Cahudisa/Proyecto-Medidor-de-Corriente-para-Microcontroladores/PCB/modulo_bateria/How-to-order-PCB.txt

How to Order PCB

Please refer to:
https://docs.easyeda.com/en/PCB/Order-PCB
