Cahudisa/Proyecto-Medidor-de-Corriente-para-Microcontroladores/costos.pdf

Manufacturer Part | Precio unidad USD | Precio al por mayor USD | Total unidad 25 | Total al por mayor 25
AD8628ARTZ-REEL7 | 4.69 | 2.6124 | 117.25 | 65.31
CC0603JRX7R9BB473 | 0.1 | 0.056 | 2.5 | 1.4
CC0402JRX7R7BB104 | 0.08 | 0.01 | 2 | 0.25
C0805C106J8RACAUTO | 0.88 | 0.556 | 22 | 13.9
LMV761MFX | 2.13 | 1.4348 | 53.25 | 35.87
PESDNC5D5VB | 0.03689 | 0.03689 | 0.92225 | 0.92225
ASMD1206-035 | 0.0691 | 0.0691 | 1.7275 | 1.7275
PTC120612V200 | 0.5 | 0.5 | 12.5 | 12.5
RT0805BRD074R7L | 0.18 | 0.131 | 4.5 | 3.275
RC0805JR-0710KL | 0.1 | 0.012 | 2.5 | 0.3
INA228AQDGSRQ1 | 4.22 | 2.942 | 105.5 | 73.55
TC1262-3.3VDBTR | 0.69 | 0.58 | 17.25 | 14.5
LTST-C170GKT | 0.16 | 0.11 | 4 | 2.75
74LVC1G02GW | 0.1 | 0.0532 | 2.5 | 1.33
WJ301V-5.0-3P | 16.6 | 16.6 | 415 | 415
IRF7410TRPBF | 1.3 | 0.873 | 32.5 | 21.825
Y14870R01000B9R | 12.8 | 7.8692 | 320 | 196.73
CPF0402B10RE1 | 0.25 | 0.211 | 6.25 | 5.275
RN73H1JTTD1002B25 | 0.1 | 0.082 | 2.5 | 2.05
RN73H1JTTD3602B25 | 0.1 | 0.082 | 2.5 | 2.05
RG1608P-471-B-T5 | 0.1 | 0.076 | 2.5 | 1.9
RT0603BRD07120RL | 0.14 | 0.108 | 3.5 | 2.7
RT0603BRD0739K2L | 0.14 | 0.104 | 3.5 | 2.6
D55342E07B500BRWS | 9.7504 | 9.7504 | 243.76 | 243.76
EG1218 | 0.84 | 0.664 | 21 | 16.6
74LVC1G32GW/C4125 | 0.1 | 0.05 | 2.5 | 1.25
ESP32-S2-SOLO-2-N4R2 | 4.51 | 3.6904 | 112.75 | 92.26
BD4928G-TR | 0.54 | 0.3388 | 13.5 | 8.47
FS312F-G | 0.0694 | 0.279 | 1.735 | 6.975
Green LED | 0.005 | 0.005 | 0.125 | 0.125
Red LED | 0.006 | 0.006 | 0.15 | 0.15
100R | 0.0011 | 0.0011 | 0.0275 | 0.0275
2R2 | 0.16 | 0.16 | 4 | 4
91K | 0.005 | 0.005 | 0.125 | 0.125
120K | 0.0236 | 0.0236 | 0.59 | 0.59
1K | 0.0011 | 0.0011 | 0.0275 | 0.0275
270K | 0.007 | 0.007 | 0.175 | 0.175
910K | 0.008 | 0.008 | 0.2 | 0.2
51K | 0.006 | 0.006 | 0.15 | 0.15
47K | 0.006 | 0.006 | 0.15 | 0.15
FS8205 | 0.37 | 0.37 | 9.25 | 9.25
MCW-0630-1R5-S1 | 0.1 | 0.1 | 2.5 | 2.5
10uF / 16V | 0.1 | 0.1 | 2.5 | 2.5
22uF / 10V | 0.1 | 0.1 | 2.5 | 2.5
100nF / 50V | 0.1 | 0.1 | 2.5 | 2.5
IP2312U | 0.25 | 0.25 | 6.25 | 6.25
U254-051N-4BH806 | 0.5 | 0.5 | 12.5 | 12.5
Costo de fabricación | 28.82 | 28.82 | 720.5 | 720.5
Suma total | 91.84459 | 80.44999 | 2296.11475 | 2011.24975
