Cahudisa/Proyecto-Medidor-de-Corriente-para-Microcontroladores/PCB/modulo_bateria/Diagrama Esquematico Tema Oscuro.pdf

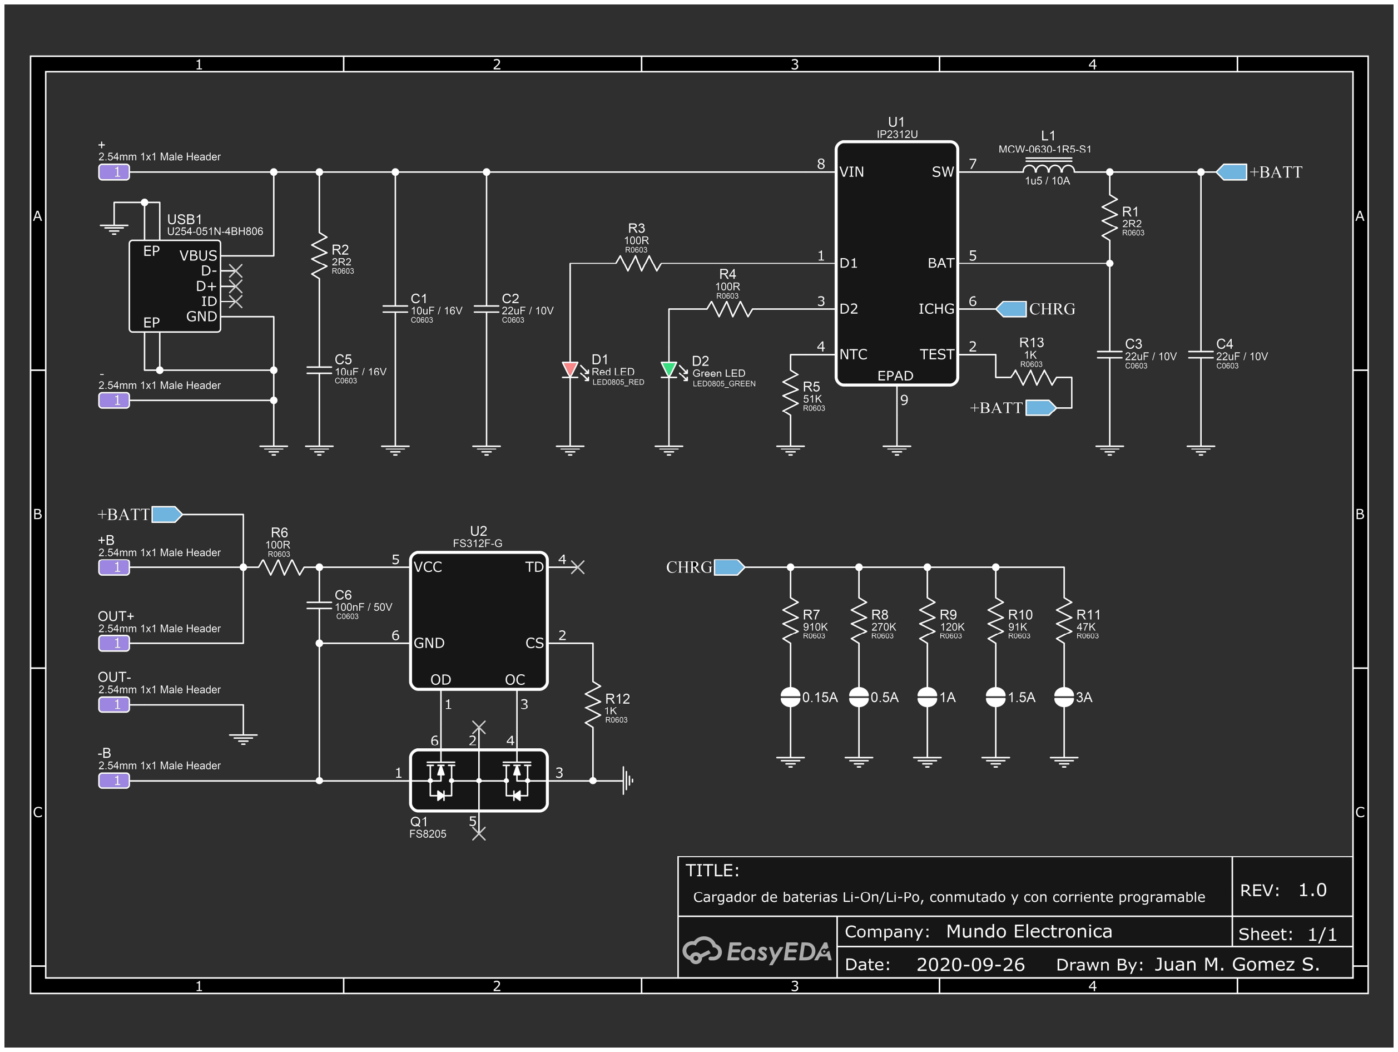
[picture p23: page 1]
