Cahudisa/Proyecto-Medidor-de-Corriente-para-Microcontroladores/PCB/modulo_bateria/BOM_modulo_bateria.pdf

ID | Name | Designator | Footprint | Quantity
1 | FS312F-G | U2 | SOT-23-6 | 1
2 | Green LED | D2 | 0805 | 1
3 | Red LED | D1 | 0805 | 1
4 | 100R | R3,R6,R4 | 0603 | 3
5 | 2R2 | R1,R2 | 0603 | 2
6 | 91K | R10 | 0603 | 1
7 | 120K | R9 | 0603 | 1
8 | 1K | R12,R13 | 0603 | 2
9 | 270K | R8 | 0603 | 1
10 | 910K | R7 | 0603 | 1
11 | 51K | R5 | 0603 | 1
12 | 47K | R11 | 0603 | 1
13 | FS8205 | Q1 | SOT-23-6 | 1
14 | MCW-0630-1R5-S1 | L1 | N/A | 1
15 | 10uF / 16V | C5,C1 | 0603 | 2
16 | 22uF / 10V | C3,C4,C2 | 0603 | 3
17 | 100nF / 50V | C6 | 0603 | 1
18 | IP2312U | U1 | N/A | 1
19 | U254-051N-4BH806 | USB1 | N/A | 1
