Cahudisa/Proyecto-Medidor-de-Corriente-para-Microcontroladores/PCB/BOM_Proyecto_final_DSE_2025-05-28.csv

ID | Name | Designator | Footprint | Quantity | Manufacturer Part | Manufacturer | Supplier | Supplier Part | Price
1 | AD8628ARTZ-REEL7 | AD8628 | SOT-23-5_L3.0-W1.7-P0.95-LS2.8-BR | 1 | AD8628ARTZ-REEL7 | ADI(亚德诺) | LCSC | C29309 | 1.895
2 | HDR-M-2.54_1x1 | BOOT,RX,TX,VBAT+,VBAT- | HDR-M-2.54_1X1 | 5 |  |  | LCSC | C81276 | 0.007
3 | 47nF | C1,C2 | C0603 | 2 | CC0603JRX7R9BB473 | YAGEO | LCSC | C519554 | 0.004
4 | 100nF | C3,C6 | C0402 | 2 | CC0402JRX7R7BB104 | YAGEO(国巨) | LCSC | C541464 | 0.002
5 | 10uF | C4,C5,C7,C8 | C0805 | 4 | C0805C106J8RACAUTO | KEMET | LCSC | C599861 | 0.664
6 | LMV761MFX | COMP1,COMP2 | SOT-23-6_L2.9-W1.6-P0.95-LS2.8-BR | 2 | LMV761MFX | TI(德州仪器) | LCSC | C2861042
7 | PESDNC5D5VB | D1 | SOD-523_L1.2-W0.8-LS1.6-BI | 1 | PESDNC5D5VB | Prisemi(芯导) | LCSC | C110698 | 0.02
8 | ASMD1206-035 | F1 | F1206 | 1 | ASMD1206-035 | JDTfuse(集电通) | LCSC | C135337 | 0.052
9 | PTC120612V200 | F2 | F1206 | 1 | PTC120612V200 | null | LCSC | C9900019163
10 | 4.7Ω | F3 | R0805 | 1 | RT0805BRD074R7L | YAGEO(国巨) | LCSC | C784587 | 0.046
11 | 10kΩ | R6,R7,R8,R9 | R0805 | 4 | RC0805JR-0710KL | YAGEO(国巨) | LCSC | C100047 | 0.002
12 | INA228AQDGSRQ1 | INA228 | VSSOP-10_L3.0-W3.0-P0.50-LS4.9-BL | 1 | INA228AQDGSRQ1 | TI(德州仪器) | LCSC | C5214669 | 4.007
13 | TC1262-3.3VDBTR | LDO | SOT-223_L6.5-W3.5-P2.30-LS7.0-BR | 1 | TC1262-3.3VDBTR | MICROCHIP(美国微芯) | LCSC | C52507 | 1.393
14 | LTST-C170GKT | LED1 | LED0805-RD_GREEN | 1 | LTST-C170GKT | LITEON(光宝) | LCSC | C125090 | 0.026
15 | 74LVC1G02GW | NOR1,NOR2 | SOT-353_L2.1-W1.3-P0.65-LS2.3-BL | 2 | 74LVC1G02GW | TECH PUBLIC(台舟) | LCSC | C41407550 | 0.037
16 | WJ301V-5.0-3P | P1 | CONN-TH_2P-P5.00_WJ301V-5.00-3P | 1 | WJ301V-5.0-3P | KANGNEX(康奈克斯电气) | LCSC | C8483 | 0.122
17 | ISCH42N04LM7ATMA1 | Q1_NMOS,Q2_NMOS,Q3_NMOS | IAUC120N06S5N011ATMA1 | 3
18 | IRF7410TRPBF_C5370971 | Q2_PMOS | SOP-8_L5.1-W3.9-P1.27-LS6.0-BL | 1 | IRF7410TRPBF | TECH PUBLIC(台舟) | LCSC | C5370971 | 0.232
19 | 10mΩ | R1 | RES-SMD_4P-L6.4-W3.2-A | 1 | Y14870R01000B9R | VISHAY(威世) | LCSC | C4147986 | 3.892
20 | 10Ω | R2 | R0402 | 1 | CPF0402B10RE1 | TE Connectivity(泰科电子) | LCSC | C2073458 | 0.133
21 | 10kΩ | R3,R4 | R0603 | 2 | RN73H1JTTD1002B25 | KOA | LCSC | C186210 | 0.226
22 | 36kΩ | R5,R10 | R0603 | 2 | RN73H1JTTD3602B25 | KOA | LCSC | C186223 | 0.096
23 | 470Ω | R11 | R0603 | 1 | RG1608P-471-B-T5 | SUSUMU | LCSC | C328637 | 0.149
24 | 120Ω | R12 | R0603 | 1 | RT0603BRD07120RL | YAGEO(国巨) | LCSC | C861094 | 0.024
25 | 39.2kΩ | R13 | R0603 | 1 | RT0603BRD0739K2L | YAGEO(国巨) | LCSC | C861369 | 0.024
26 | 500kΩ | R14 | R1206 | 1 | D55342E07B500BRWS | VISHAY(威世) | LCSC | C4018189 | 12.621
27 | EG1218 | SW2 | SW-TH_EG1218 | 1 | EG1218 | E-Switch | LCSC | C273394 | 0.744
28 | 74LVC1G32GW/C4125 | U1,U2 | TSSOP-5_L2.0-W1.3-P0.65-LS2.1-BR | 2 | 74LVC1G32GW/C4125 | NXP(恩智浦) | LCSC | C4470879 | 0.033
29 | ESP32-S2-SOLO-2-N4R2 | U4 | WIRELM-SMD_ESP32-S3-WROOM-1 | 1 | ESP32-S2-SOLO-2-N4R2 | ESPRESSIF(乐鑫) | LCSC | C7188709 | 3.789
30 | BD4928G-TR | U6 | SSOP-5_L2.9-W1.6-P0.95-LS2.8-TL | 1 | BD4928G-TR | ROHM(罗姆) | LCSC | C2066490 | 0.239
