Cahudisa/Proyecto-Medidor-de-Corriente-para-Microcontroladores/PCB/modulo_bateria/Diagrama Esquematico Tema Blanco.pdf

U1

R2

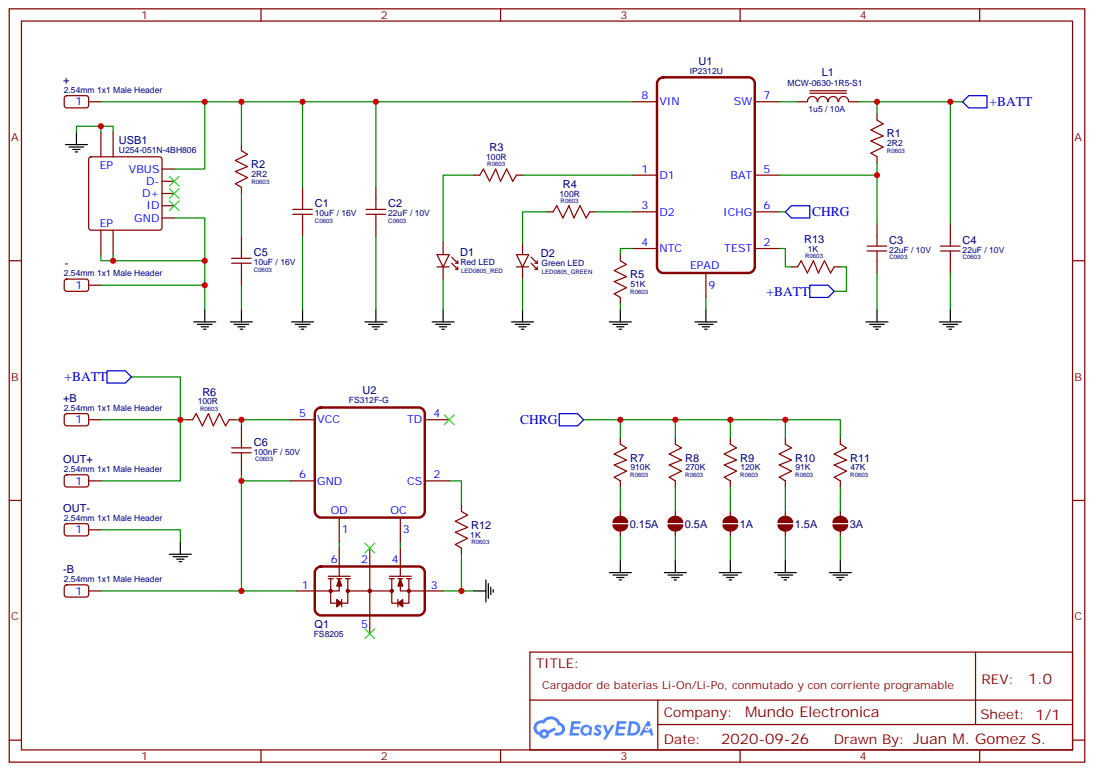
[picture p24: page 1]

Drawn By: Juan M. Gomez S.
