Cahudisa/Proyecto-Medidor-de-Corriente-para-Microcontroladores/Simulacion/AD8628_char.asc

R1: res; 1k
U1: AD8628
U2: AD8628
V1: voltage; 0.5
V2: voltage; 0
Vdd1: voltage; 3.3
Named nets: vdd3, 0, vout, v+, v-, vout_noise
.op
.dc V1 0.3 1.2 0.0001
.meas DC min MIN v(vout) FROM 0.99 TO 1.01
.meas DC max MAX v(vout) FROM 0.99 TO 1.02
.meas DC vtrig TRIG v(vout)=min CROSS=last TARG v(vout)=max
.meas DC offset FIND v(vout) WHEN v(vout)=3.3/2-0.001
.noise v(vout_noise) V2 dec 100 1 10g
