Cahudisa/Proyecto-Medidor-de-Corriente-para-Microcontroladores/Simulacion/Control digital.asc

C1: cap; 1µ
C2: cap; 1µ
R1: res; 40.3k
R2: res; 470
R3: res; 32.9k
R4: res; 100
U1: TLV3501
U2: TLV3501
U3: LT1017
U4: LT1017
Vdd1: voltage; 3.3
Vdd2: voltage; PULSE(1m 50m 1u 1000m 1000m)
Named nets: 0, vdd1, vmax, vmin, vout, vmaxc, vminc, vmaxc2, vminc2
.include LMV761.lib
.dc Vdd2 8m 40m
.tran 1
.include TLV3501.lib
