Cahudisa/Proyecto-Medidor-de-Corriente-para-Microcontroladores/Simulacion/preamp_auto_tran.asc

A1: srflop
C1: cap; {C}
C2: cap; {C}
C3: cap; 1µ
C4: cap; 1µ
E1: e; 3.3
E2: e; 3.3
I1: current; PULSE(1u 1.5m 10u 5 5)
M1: nmos; ISCH42N04LM7_L0
M2: nmos; ISCH42N04LM7_L0
M3: nmos; ISCH42N04LM7_L0
R1: res; {Rin}
R2: res; {Rin}
R3: res; {Rf}
R4: res; {Rf}
R5: res; {Rshunt}
R6: res; {Rshunt2}
R9: res; 39.3k
R10: res; 470
R11: res; 500k
R12: res; 5
U1: AD8628
U2: LT1017; LMV761
U3: LT1017; LMV761
Vdd1: voltage; 3.3
Named nets: vdd, 0, vout, vmos, vmosn, vmax, vmin, vmaxc, vminc, vshunt
.dc I1 1u 1
.tran 10
Low side
.include OptiMOS7_40V_LTSpice.lib
.param C = 47n
.param Iload = 1
.param scale = 10
.param Rin = 1k*scale
.param Rf 3.6k*scale
.param tol = 0.001
.param tolcap = 0.05
.param Rshunt = 10m
.param Rshunt2 = 10
.include LMV761.lib
