Cahudisa/Proyecto-Medidor-de-Corriente-para-Microcontroladores/Simulacion/Preamp_mA_noise.asc

C1: cap; {C}
C2: cap; {C}
I1: current; {Iload}
M1: nmos; ISCH42N04LM7_L0
M2: nmos; ISCH42N04LM7_L0
M3: nmos; ISCH42N04LM7_L0
R1: res; {Rin}
R2: res; {Rin}
R3: res; {Rf}
R4: res; {Rf}
R5: res; {Rshunt}
R6: res; {Rshunt2}
R7: res; 100 noiseless
R8: res; 100 noiseless
U1: AD8628
V1: voltage; 3.3
V2: voltage; 0
Vdd1: voltage; 3.3
Named nets: vdd3, 0, vout, vmos, vmosn, vshunt+, vshunt-, v+, v-
.op
Low side
.include OptiMOS7_40V_LTSpice.lib
.noise v(vout) I1 dec 100 1 20meg
.param C = 47n
.param Iload = 1
.param scale = 10
.param Rin = 1k*scale
.param Rf 3.6k*scale
.param tol = 0.001
.param tolcap = 0.05
.param Rshunt = 10m
.param Rshunt2 = 10
