Cahudisa/Proyecto-Medidor-de-Corriente-para-Microcontroladores/Simulacion/Preamp_mc.asc

C1: cap; {mc(C,tolcap)}
C2: cap; {mc(C,tolcap)}
C3: cap; {mc(C,tolcap)}
C4: cap; {mc(C,tolcap)}
I1: current; {Iload1}
I2: current; {Iload2}
M1: nmos; ISCH42N04LM7_L0
M2: nmos; ISCH42N04LM7_L0
M3: nmos; ISCH42N04LM7_L0
R1: res; 1k
R2: res; {mc(Rin,tol)}
R3: res; {mc(Rin,tol)}
R4: res; {mc(Rf,tol)}
R5: res; {mc(Rf,tol)}
R6: res; {mc(Rin,tol)}
R7: res; {mc(Rin,tol)}
R8: res; {mc(Rf,tol)}
R9: res; {mc(Rf,tol)}
R10: res; {mc(Rshunt2,tol)}
R11: res; {mc(Rshunt,tol)}
R12: res; 1k
R13: res; {mc(Rshunt,tol)}
U1: AD8628
U3: AD8628
V1: voltage; 3.3
V2: voltage; 0
Vdd1: voltage; 3.3
Vdd2: voltage; 3.3
Named nets: 0, vdd2, vout2, vdd1, vout1, vmos, vmosn
.param C = 47n
.param Iload1 = 1u
.param Iload2 = 1m
.param scale = 10
.param Rin = 1k*scale
.param Rf 3.6k*scale
.param tol = 0.001
.param tolcap = 0.05
.param Rshunt = 10
.param Rshunt2 = 10m
.step param run 1 300 1
.dc I3 1m 1
.tran 3m
.op
.include OptiMOS7_40V_LTSpice.lib
