Cahudisa/Proyecto-Medidor-de-Corriente-para-Microcontroladores/Simulacion/Preamp_uA_DC.asc

C5: cap; {C}
C6: cap; {C}
I1: current; {Iload}
R11: res; {Rin}
R12: res; {Rin}
R13: res; {Rf}
R14: res; {Rf}
R15: res; {Rshunt}
U5: AD8628
Vdd3: voltage; 3.3
Named nets: vdd3, 0, vout, vshunt, v+, v-
.param C = 47n
.param Iload = 1m
.param scale = 10
.param Rin = 1k*scale
.param Rf 3.6k*scale
.param tol = 0.001
.param tolcap = 0.05
.param Rshunt = 10
.dc I1 1m 1
.op
Low side
.include OptiMOS7_40V_LTSpice.lib
