Cahudisa/Proyecto-Medidor-de-Corriente-para-Microcontroladores/Simulacion/Preamp_uA_noise.asc

C1: cap; {C}
C2: cap; {C}
I1: current; 10µ
R1: res; {Rin}
R2: res; {Rin}
R3: res; {Rf}
R4: res; {Rf}
R5: res; {Rshunt}
U1: AD8628
U2: AD8628
Vdd1: voltage; 3.3
Named nets: vdd3, 0, vout, vshunt
.param C = 47n
.param Iload = 1m
.param scale = 100
.param Rin = 1k*scale
.param Rf 3.6k*scale
.param tol = 0.001
.param tolcap = 0.05
.param Rshunt = 10
.op
Low side
.include OptiMOS7_40V_LTSpice.lib
.noise v(vout) I1 dec 100 1 1G
