Cahudisa/Proyecto-Medidor-de-Corriente-para-Microcontroladores/(list of files, drawings)

Other design files:
blynk.pdsprj
